8BitSky/Sumo/sumoshieldv1.pdf

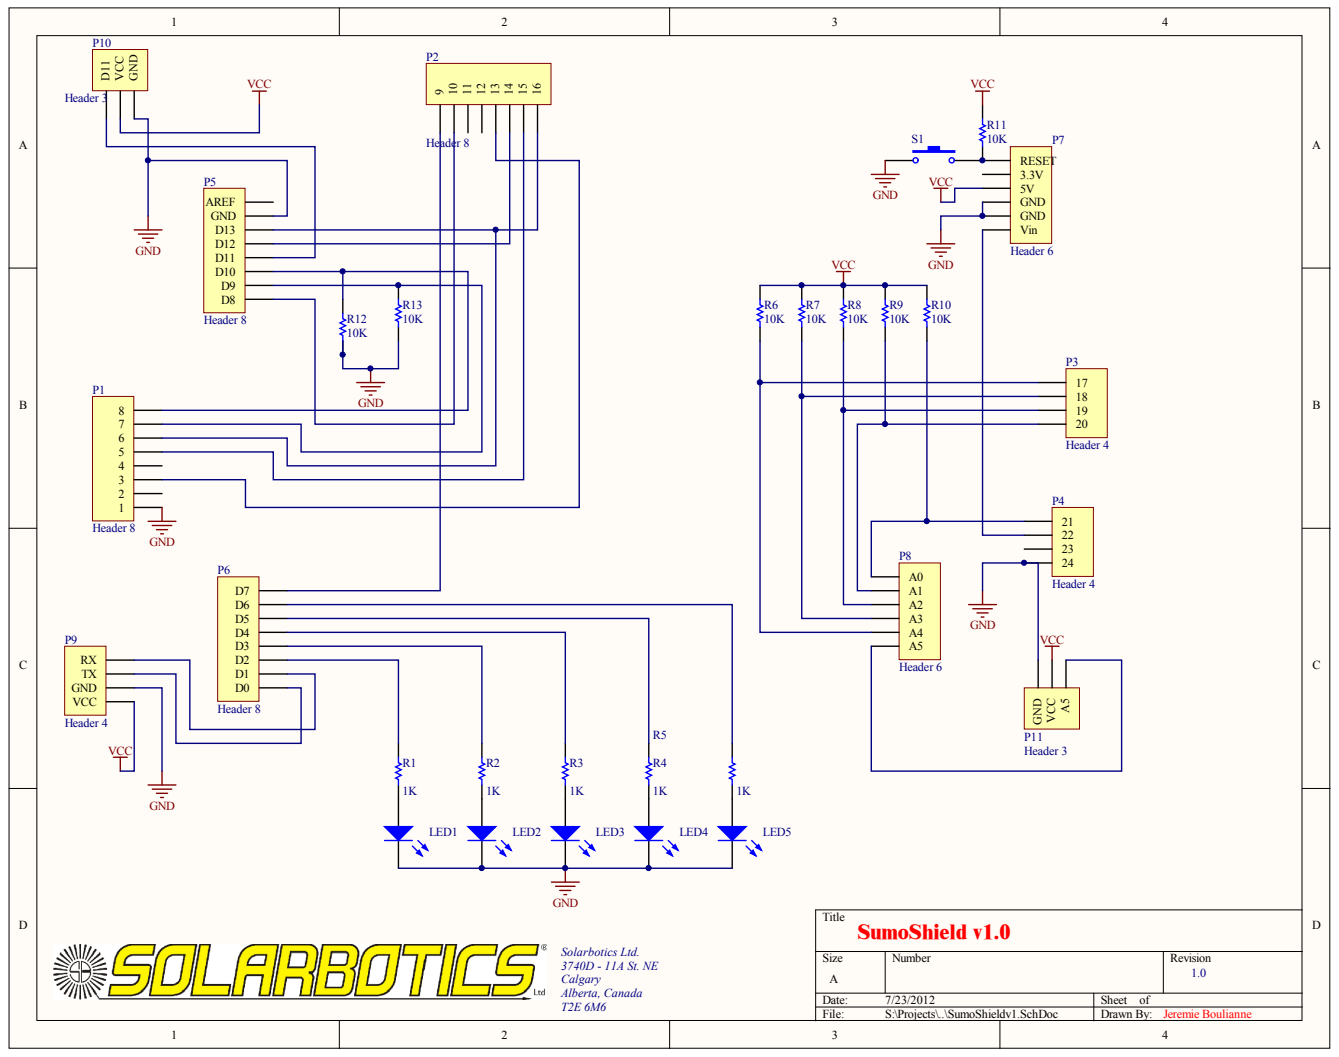
[picture p9: page 1]

D10
D9 D8
